dzid26/OpenpilotHardware/BlackPanda/kicad_project/BlackPanda.kicad_pcb

## KiCad design BlackPanda/kicad_project/BlackPanda.kicad_pcb (2024-02-05)

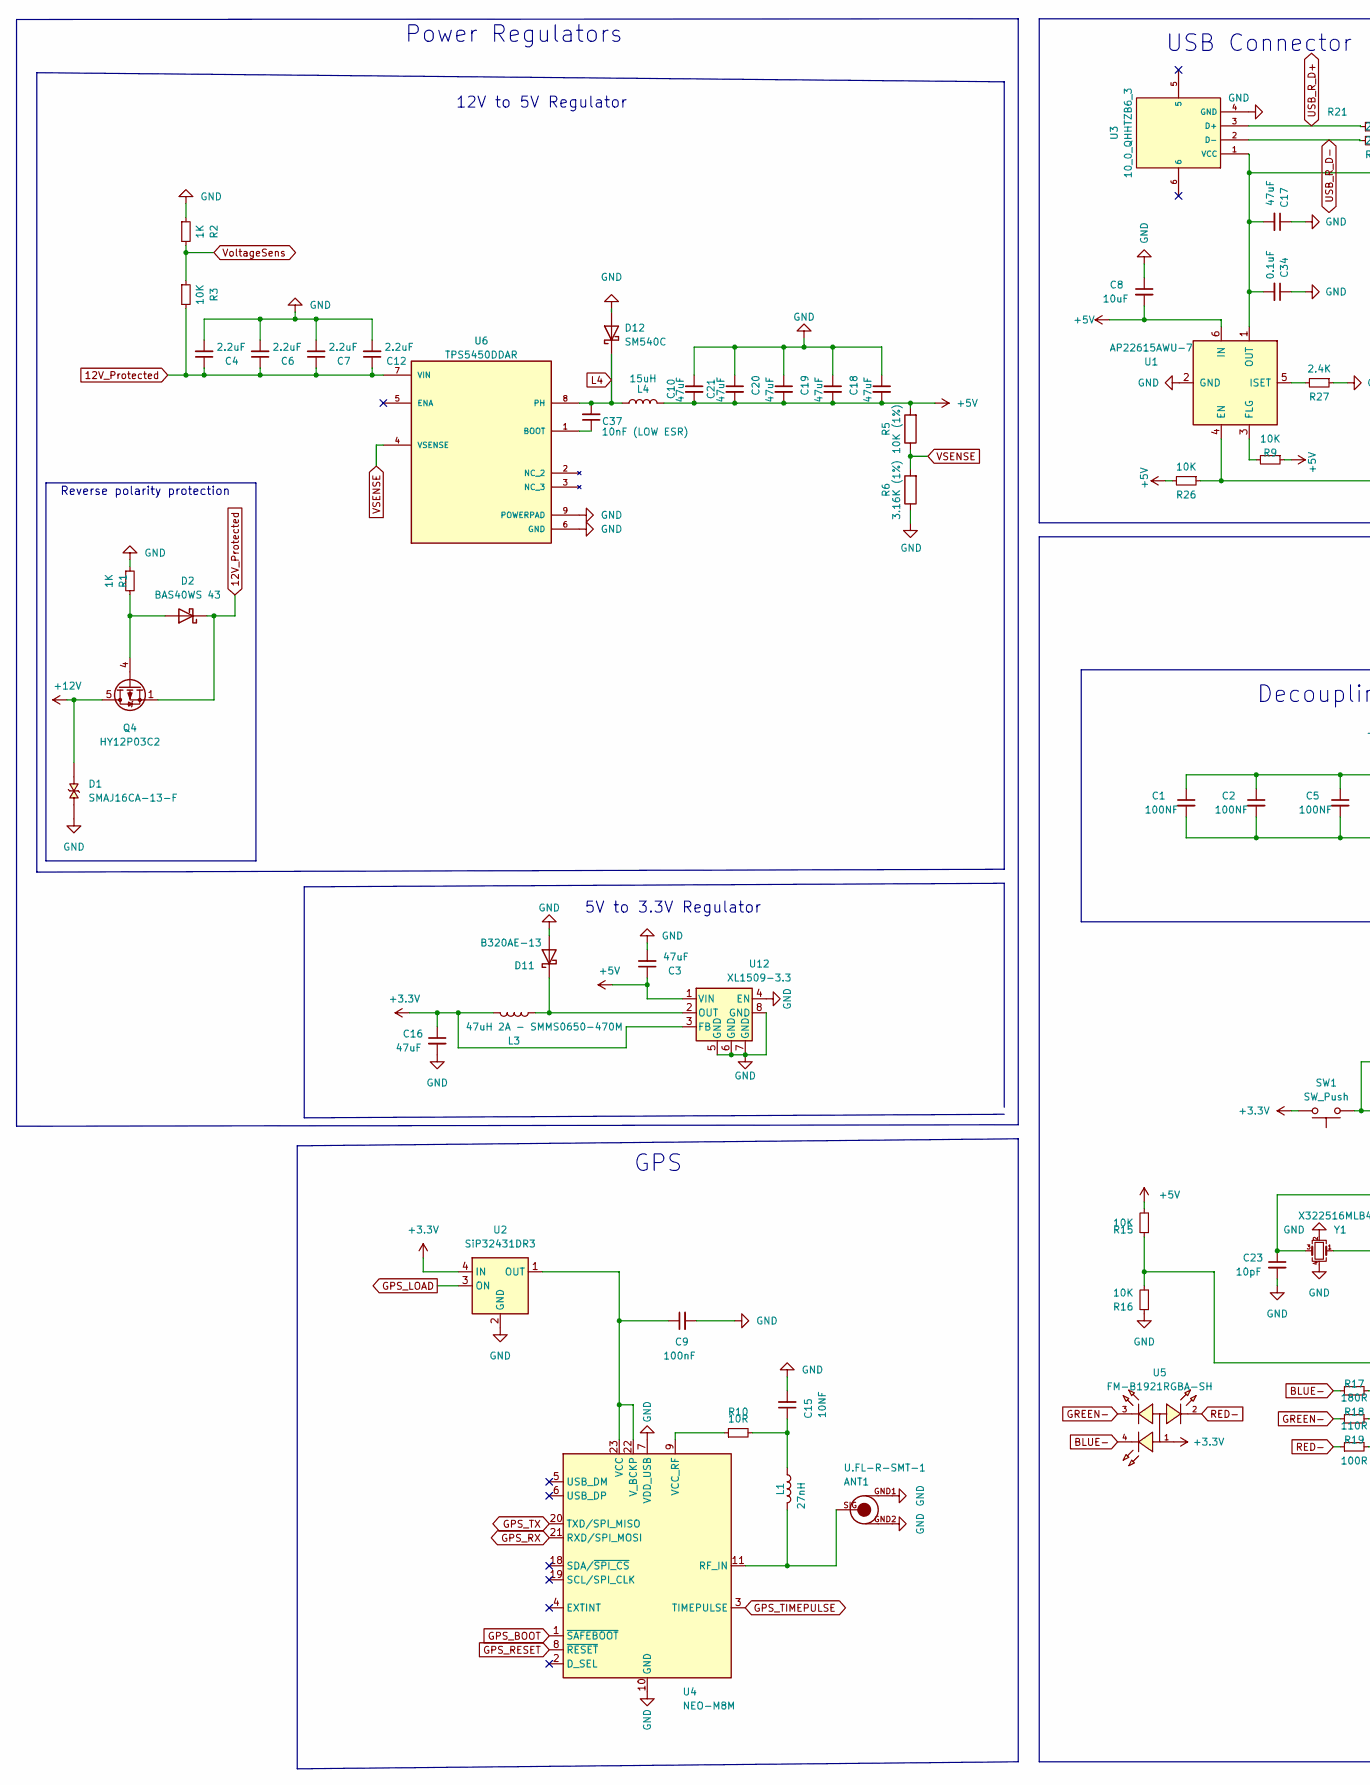
[picture p1: schematic BlackPanda.kicad_sch, OpenPanda, part in row 1, column 1]

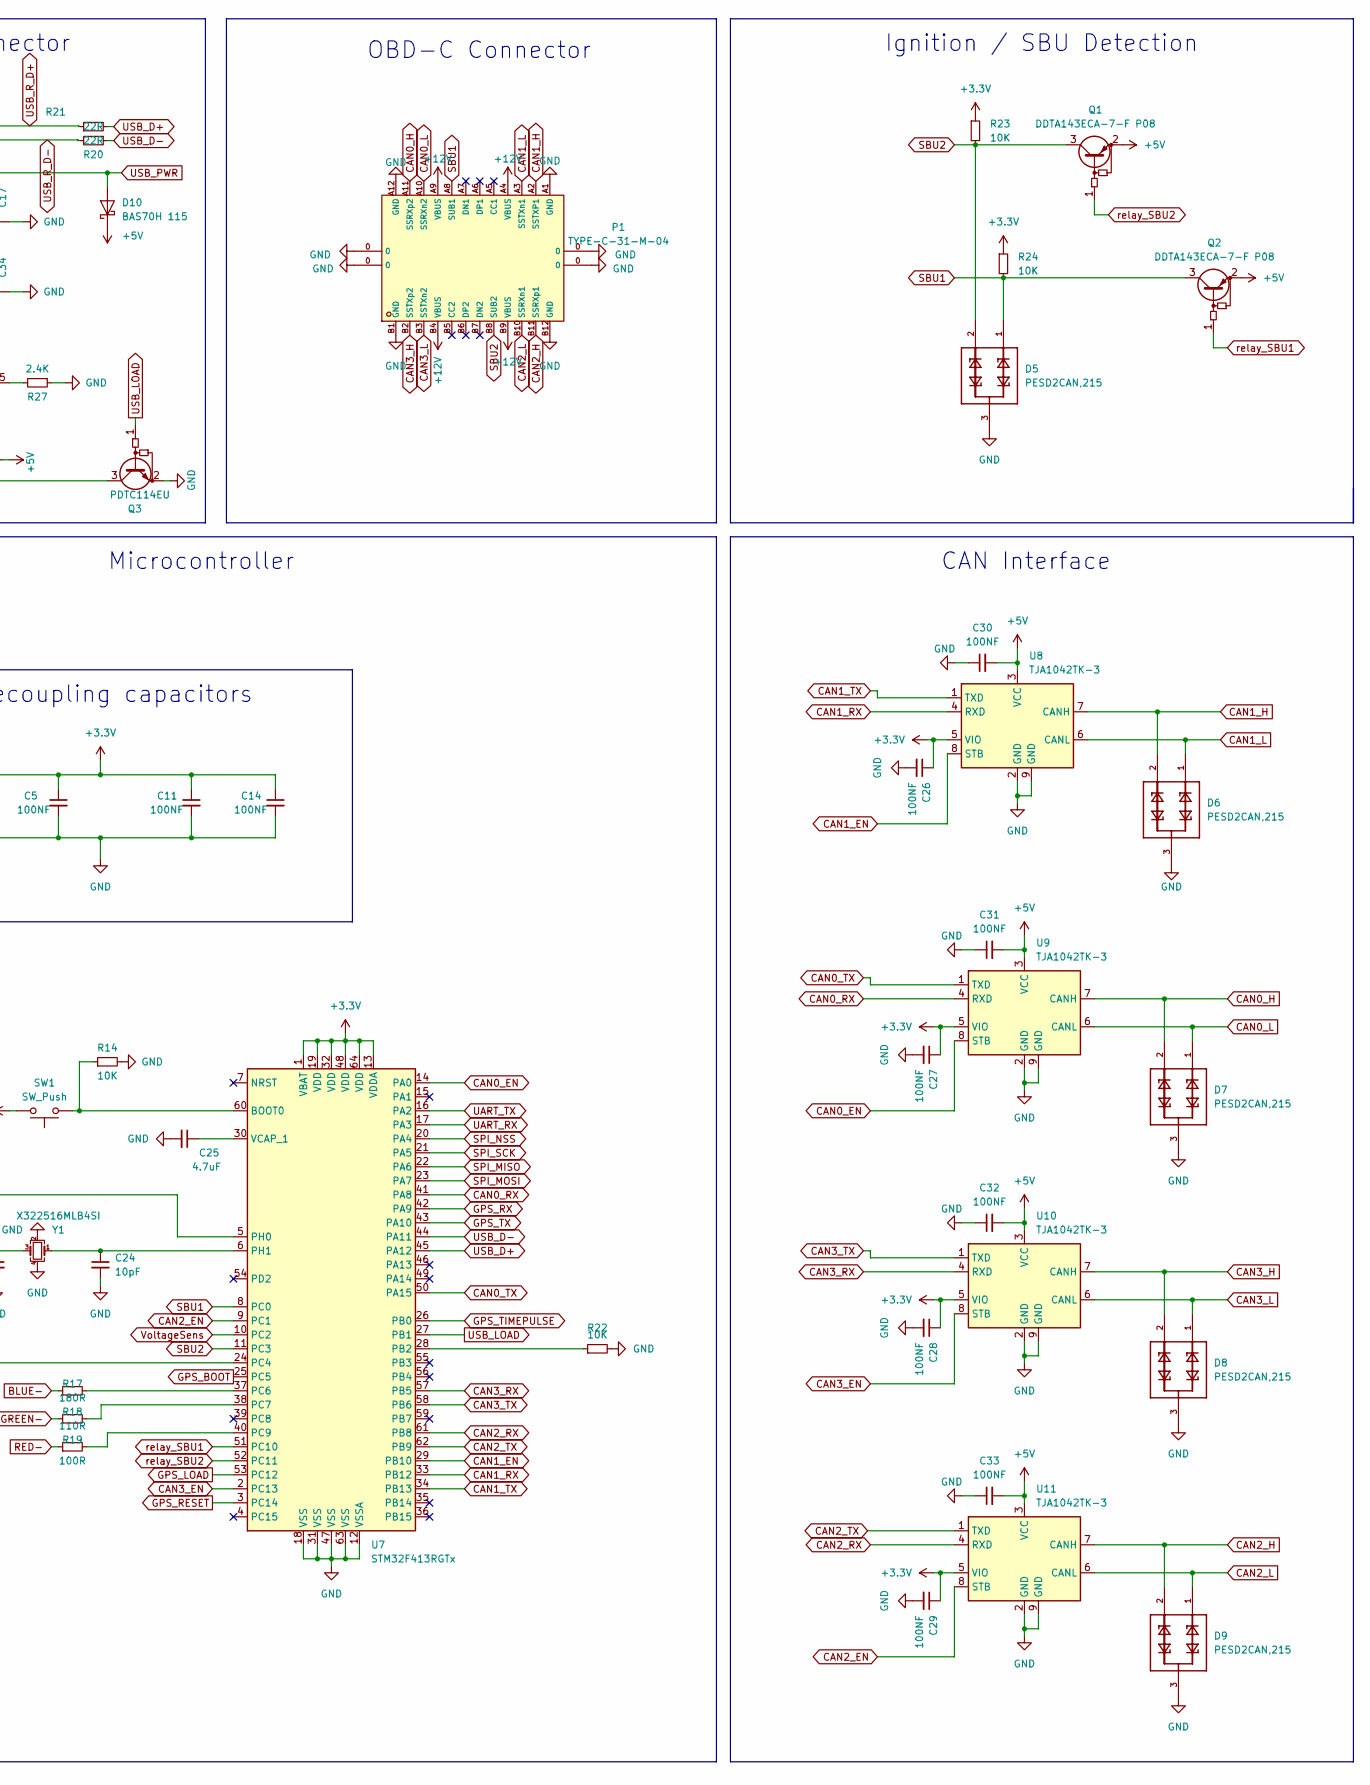
[picture p2: schematic BlackPanda.kicad_sch, OpenPanda, part in row 1, column 2]

Parts:
ANT1: U.FL-R-SMT-1; PARTNUMBER U.FL-R-SMT(10)
C1, C2, C5, C11, C14, C26, C27, C28, C29, C30, C31, C32, C33: 100NF; C_0402_1005Metric
C3, C10, C16, C17, C18, C19, C20, C21: 47uF; C_0805_2012Metric
C4, C6, C7, C12: 2.2uF; C_0805_2012Metric
C8: 10uF; C_0402_1005Metric
C9: 100nF; C_0603_1608Metric
C15: 10NF; C_0402_1005Metric
C23, C24: 10pF; C_0402_1005Metric
C25: 4.7uF; C_0402_1005Metric
C34: 0.1uF; C_0402_1005Metric
C37: 10nF (LOW ESR); C_0402_1005Metric
D1: SMAJ16CA-13-F; DIOM4325X250N; PARTREV S2102
D2: BAS40WS 43; D_SOD-323
D5, D6, D7, D8, D9: PESD2CAN,215; SOT95P230X110-3N
D10: BAS70H 115; D_SOD-123F
D11: B320AE-13; D_SMA
D12: SM540C; D_SMC
L1: 27nH; L_0603_1608Metric
L3: 47uH 2A - SMMS0650-470M; IND-SMD_L7.3-W6.8; JLCPCB C149588
L4: 15uH; L_10.5x11.5_H4.0
P1: TYPE-C-31-M-04; USB-C-SMD_TYPE-C-USB-20; LCSC C129018
Q1, Q2: DDTA143ECA-7-F P08; SOT23-3
Q3: PDTC114EU; SOT-323_SC-70
Q4: HY12P03C2; PowerPAK_SO-8_Single
R1, R2: 1K; R_0402_1005Metric
R3, R9, R14, R15, R16, R22, R23, R24, R26: 10K; R_0402_1005Metric
R5: 10K (1%); R_0402_1005Metric
R6: 3.16K (1%); C_0603_1608Metric
R10: 10R; R_0402_1005Metric
R17: 180R; R_0402_1005Metric
R18: 110R; R_0402_1005Metric
R19: 100R; R_0402_1005Metric
R20, R21: 22R; R_0402_1005Metric
R27: 2.4K; R_0402_1005Metric
SW1: SW_Push; SW_SPST_SKQG_WithStem
U1: AP22615AWU-7; SOT-23-6
U2: SiP32431DR3; SOT-363_SC-70-6
U3: 10_0_QHHTZB6_3; USB-A-TH_10.0QHHTZB6.3; LCSC C668591
U4: NEO-M8M; ublox_NEO
U5: FM-B1921RGBA-SH; LED-ARRAY-SMD_4P-L2.2-W2.1-BR; LCSC C727904
U6: TPS5450DDAR; CONV_TPS5450DDAR; PARTREV D
U7: STM32F413RGTx; LQFP-64_10x10mm_P0.5mm
U8, U9, U10, U11: TJA1042TK-3; HVSON-8-1EP_3x3mm_P0.65mm_EP1.6x2.4mm
U12: XL1509-3.3; Diodes_PSOP-8
Y1: X322516MLB4SI; Crystal_SMD_3225-4Pin_3.2x2.5mm

Connections:
12V_Protected: C4.1, C6.1, C7.1, C12.1, D2.1 (K), Q4.1 (S), Q4.2 (S), Q4.3 (S), R3.2, U6.7 (VIN)
+3V3: C1.1, C2.1, C5.1, C11.1, C14.1, C16.1, C26.1, C27.1, C28.1, C29.1, L3.2, R23.1, R24.1, SW1.2, U2.4 (IN), U5.1 (+), U7.1 (VBAT), U7.13 (VDDA), U7.19 (VDD), U7.32 (VDD), U7.48 (VDD), U7.64 (VDD), U8.5 (VIO), U9.5 (VIO), U10.5 (VIO), U11.5 (VIO), U12.3 (FB)
+5V: C3.1, C8.2, C10.2, C18.2, C19.2, C20.2, C21.2, C30.2, C31.2, C32.2, C33.2, D10.1 (K), L4.2, Q1.2 (E), Q2.2 (E), R5.2, R9.1, R15.2, R26.2, U1.6 (IN), U8.3 (VCC), U9.3 (VCC), U10.3 (VCC), U11.3 (VCC), U12.1 (VIN)
+12V: D1.2, P1.A4 (VBUS), P1.A9 (VBUS), P1.B4 (VBUS), P1.B9 (VBUS), Q4.5 (D)
BLUE-: R17.1, U5.4 (B-)
CAN0_EN: U7.14 (PA0), U9.8 (STB)
CAN0_H: D7.2, P1.A11 (SSRXp2), U9.7 (CANH)
CAN0_L: D7.1, P1.A10 (SSRXn2), U9.6 (CANL)
CAN0_RX: U7.41 (PA8), U9.4 (RXD)
CAN0_TX: U7.50 (PA15), U9.1 (TXD)
CAN1_EN: U7.29 (PB10), U8.8 (STB)
CAN1_H: D6.2, P1.A2 (SSTXP1), U8.7 (CANH)
CAN1_L: D6.1, P1.A3 (SSTXn1), U8.6 (CANL)
CAN1_RX: U7.33 (PB12), U8.4 (RXD)
CAN1_TX: U7.34 (PB13), U8.1 (TXD)
CAN2_EN: U7.9 (PC1), U11.8 (STB)
CAN2_H: D9.2, P1.B11 (SSRXp1), U11.7 (CANH)
CAN2_L: D9.1, P1.B10 (SSRXn1), U11.6 (CANL)
CAN2_RX: U7.61 (PB8), U11.4 (RXD)
CAN2_TX: U7.62 (PB9), U11.1 (TXD)
CAN3_EN: U7.2 (PC13), U10.8 (STB)
CAN3_H: D8.2, P1.B2 (SSTXp2), U10.7 (CANH)
CAN3_L: D8.1, P1.B3 (SSTXn2), U10.6 (CANL)
CAN3_RX: U7.57 (PB5), U10.4 (RXD)
CAN3_TX: U7.58 (PB6), U10.1 (TXD)
GND: ANT1.GND1, ANT1.GND2, C1.2, C2.2, C3.2, C4.2, C5.2, C6.2, C7.2, C8.1, C9.2, C10.1, C11.2, C12.2, C14.2, C15.2, C16.2, C17.1, C18.1, C19.1, C20.1, C21.1, C23.2, C24.2, C25.2, C26.2, C27.2, C28.2, C29.2, C30.1, C31.1, C32.1, C33.1, C34.1, D1.1, D5.3, D6.3, D7.3, D8.3, D9.3, D11.2 (A), D12.2 (A), P1.0, P1.A1 (GND), P1.A12 (GND), P1.B1 (GND), P1.B12 (GND), Q3.2 (E), R1.1, R2.1, R6.1, R14.2, R16.1, R22.2, R27.1, U1.2 (GND), U2.2 (GND), U2.5 (GND), U3.4 (GND), U4.7 (VDD_USB), U4.10 (GND), U4.12 (GND), U4.13 (GND), U4.24 (GND), U6.6 (GND), U6.9 (POWERPAD), U7.12 (VSSA), U7.18 (VSS), U7.31 (VSS), U7.47 (VSS), U7.63 (VSS), U8.2 (GND), U8.9 (GND), U9.2 (GND), U9.9 (GND), U10.2 (GND), U10.9 (GND), U11.2 (GND), U11.9 (GND), U12.4 (EN), U12.5 (GND), U12.6 (GND), U12.7 (GND), U12.8 (GND), Y1.2, Y1.4
GPS_BOOT: U4.1 (~SAFEBOOT), U7.25 (PC5)
GPS_LOAD: U2.3 (ON), U7.53 (PC12)
GPS_RESET: U4.8 (~RESET), U7.3 (PC14)
GPS_RX: U4.21 (RXD/SPI_MOSI), U7.42 (PA9)
GPS_TIMEPULSE: U4.3 (TIMEPULSE), U7.26 (PB0)
GPS_TX: U4.20 (TXD/SPI_MISO), U7.43 (PA10)
GREEN-: R18.1, U5.3 (G-)
L4: C37.2, D12.1 (K), L4.1, U6.8 (PH)
unnamed: C15.1, L1.1, R10.2
unnamed: D2.2 (A), Q4.4 (G), R1.2
unnamed: D11.1 (K), L3.1, U12.2 (OUT)
unnamed: Q3.3 (C), R26.1, U1.4 (EN)
unnamed: R9.2, U1.3 (FLG)
unnamed: R27.2, U1.5 (ISET)
unnamed: C9.1, U2.1 (OUT), U4.22 (V_BCKP), U4.23 (VCC)
unnamed: ANT1.SIG, L1.2, U4.11 (RF_IN)
unnamed: R10.1, U4.9 (VCC_RF)
unnamed: C37.1, U6.1 (BOOT)
unnamed: R14.1, SW1.1, U7.60 (BOOT0)
unnamed: R22.1, U7.28 (PB2)
unnamed: R15.1, R16.2, U7.24 (PC4)
unnamed: R17.2, U7.37 (PC6)
unnamed: R18.2, U7.38 (PC7)
unnamed: R19.2, U7.40 (PC9)
unnamed: C23.1, U7.5 (PH0), Y1.3
unnamed: C24.1, U7.6 (PH1), Y1.1
unnamed: C25.1, U7.30 (VCAP_1)
RED-: R19.1, U5.2 (R-)
SBU1: D5.1, P1.A8 (SUB1), Q2.3 (C), R24.2, U7.8 (PC0)
SBU2: D5.2, P1.B8 (SUB2), Q1.3 (C), R23.2, U7.11 (PC3)
SPI_MISO: U7.22 (PA6)
SPI_MOSI: U7.23 (PA7)
SPI_NSS: U7.20 (PA4)
SPI_SCK: U7.21 (PA5)
UART_RX: U7.17 (PA3)
UART_TX: U7.16 (PA2)
USB_D+: R21.2, U7.45 (PA12)
USB_D-: R20.1, U7.44 (PA11)
USB_LOAD: Q3.1 (B), U7.27 (PB1)
USB_PWR: C17.2, C34.2, D10.2 (A), U1.1 (OUT), U3.1 (VCC)
USB_R_D+: R21.1, U3.3 (D+)
USB_R_D-: R20.2, U3.2 (D-)
VSENSE: R5.1, R6.2, U6.4 (VSENSE)
VoltageSens: R2.2, R3.1, U7.10 (PC2)
relay_SBU1: Q2.1 (B), U7.51 (PC10)
relay_SBU2: Q1.1 (B), U7.52 (PC11)

Notes on the sheet:
USB Connector
CAN Interface
5V to 3.3V Regulator
OBD-C Connector
Decoupling capacitors
Power Regulators
12V to 5V Regulator
Microcontroller
GPS
Ignition / SBU Detection
Reverse polarity protection

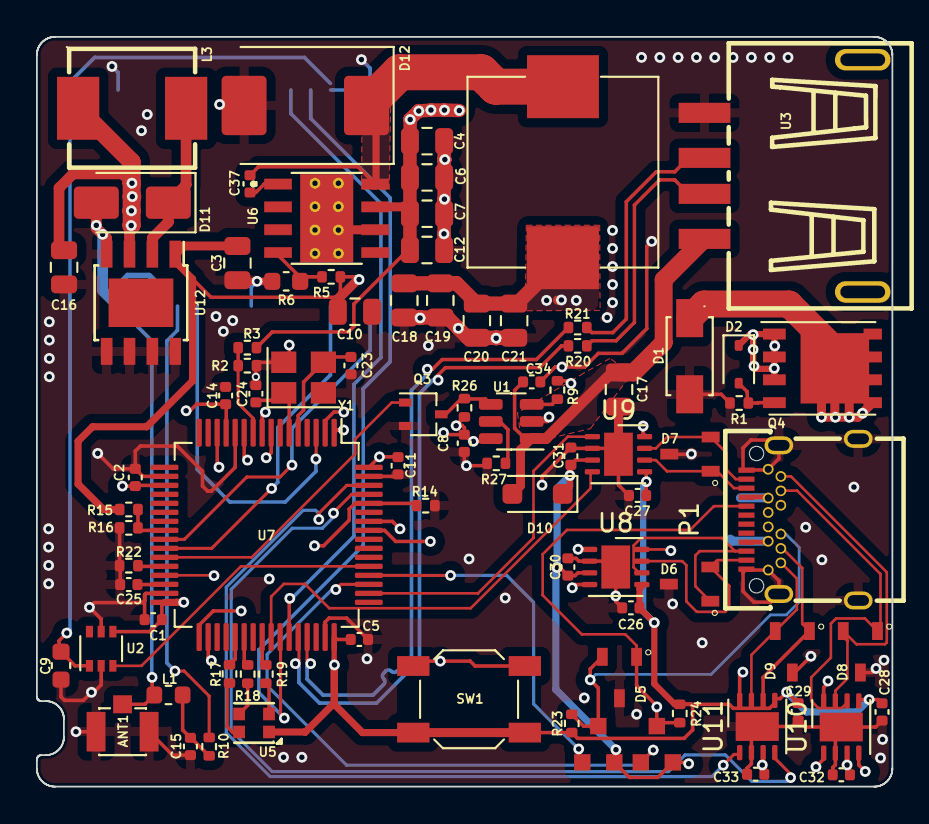
[picture p3: board BlackPanda.kicad_pcb from above]

Board: 4 copper layers, 47.5 x 41.7 mm, 86 parts (1 on the bottom side), 66 nets.
